M2I-CySat/Simulator-Interface-Board/cubesat Sim board.png

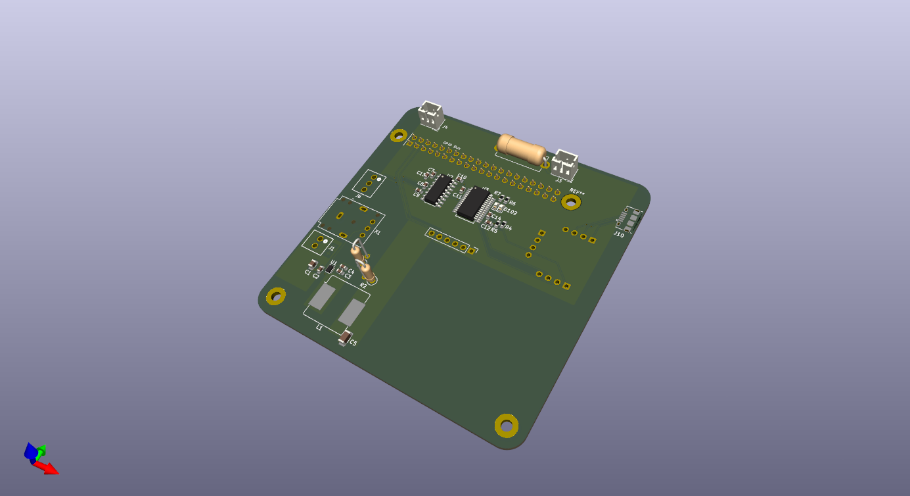
cubesat Sim board.png
