M2I-CySat/Simulator-Interface-Board/README.md

These are the KiCad project files for the Fall 2025 CySat Simulator interface board for HASP.

The files to submit to JLCPCB are in jlcpcb/production_files; the DigiKey BOM is in the main directory.
