M2I-CySat/Simulator-Interface-Board/DigiKey BOM.xlsx

Country of Origin may be different at time of shipment.
The HTSUS and ECCN information shown is for informational purposes only and is not a representation or warranty as to the accuracy or reliability of these classifications. All information is provided "as is" and is subject to change without notice. Any use made of the information provided is without recourse to Digi-Key and at the user's risk.
Index | Manufacturer Part Number | Manufacturer Name | Description | Lead Time | Availability | Stock Status | Assemblies | Attrition % | Requested Quantity 1 | Pack Quantity 1 | Pack Type 1 | Digi-Key Part Number 1 | Unit Price 1 | Extended Price 1 | Minimum Order Quantity 1 | Customer Reference | Requested Part Number | Lead Weeks | Datasheet | Reference Designator | US Import Tariff | Note | Part Status | RoHS Status | Moisture Sensitivity Level (MSL) | ECCN | HTSUS | Country of Origin | Environmental Information | Original Part numbers | Image | Product Notes
1 | OSTVN03A150 | On Shore Technology Inc. | TERM BLK 3P SIDE ENT 2.54MM PCB |  | 12,500 | In Stock | 2 |  | 1 | 2 | Bulk | ED10562-ND | 1.26000 | $2.52 | 1 |  | ED10562-ND | 8 | https://mm.digikey.com/Volume0/opasdata/d220001/medias/docus/1123/OSTVNXXA150.pdf |  | May apply on shipments to the U.S. |  | Active | ROHS3 Compliant | 1 (Unlimited) | EAR99 | 8536.90.4000 | China | https://www.on-shore.com/wp-content/uploads/RoHS3_REACH-STATEMENT-250.pdf | ED10562-ND | https://mm.digikey.com/Volume0/opasdata/d220001/medias/images/391/OSTVN03A150.jpg
2 | OSTVN02A150 | On Shore Technology Inc. | TERM BLK 2P SIDE ENT 2.54MM PCB |  | 17,626 | In Stock | 2 |  | 1 | 2 | Bulk | ED10561-ND | 0.87000 | $1.74 | 1 |  | ED10561-ND | 8 | https://mm.digikey.com/Volume0/opasdata/d220001/medias/docus/1123/OSTVNXXA150.pdf |  | May apply on shipments to the U.S. |  | Active | ROHS3 Compliant | 1 (Unlimited) | EAR99 | 8536.90.4000 | China | https://www.on-shore.com/wp-content/uploads/RoHS3_REACH-STATEMENT-250.pdf | ED10561-ND | https://mm.digikey.com/Volume0/opasdata/d220001/medias/images/410/OSTVN02A150.JPG
3 | 10118194-0001LF | Amphenol ICC (FCI) | CONN RCPT USB2.0 MICRO B SMD R/A |  | 127,424 | In Stock | 2 |  | 1 | 2 | Cut Tape (CT) | 609-4618-1-ND | 0.43000 | $0.86 | 1 |  | 609-4618-2-ND | 13 | https://cdn.amphenol-cs.com/media/wysiwyg/files/documentation/datasheet/inputoutput/io_usb_micro.pdf |  | May apply on shipments to the U.S. |  | Active | ROHS3 Compliant | 1 (Unlimited) | EAR99 | 8536.69.4040 | China |  | 609-4618-2-ND | https://mm.digikey.com/Volume0/opasdata/d220001/medias/images/525/10118194-0001LF.JPG
4 | 5999 | Adafruit Industries LLC | ADAFRUIT CH334F MINI 2-PORT USB |  | 29 | In Stock | 2 |  | 1 | 2 | Bulk | 1528-5999-ND | 4.50000 | $9.00 | 1 |  | 1528-5999-ND | 4 |  |  | N/A |  | Active | Unknown | 1 (Unlimited) | EAR99 | 8471.80.1000 | Hong Kong |  | 1528-5999-ND | https://mm.digikey.com/Volume0/opasdata/d220001/derivates/6/003/215/769/MFG_5999_web%28640x640%29.jpg
5 | SJ-3566AN | Same Sky (Formerly CUI Devices) | CONN JACK STEREO 3.5MM R/A |  | 597 | In Stock | 2 |  | 1 | 2 | Tray | CP-SJ-3566AN-ND | 1.79000 | $3.58 | 1 |  | CP-SJ-3566AN-ND | 8 | https://www.cuidevices.com/product/discontinued/sj-356xn.pdf |  | May apply on shipments to the U.S. |  | Active | ROHS3 Compliant | Not Applicable | EAR99 | 8536.69.4020 | China | https://www.cuidevices.com/product/resource/material-compliance/sj-3566an | CP-SJ-3566AN-ND | https://mm.digikey.com/Volume0/opasdata/d220001/medias/images/23/MFG_SJ-356XN.jpg
6 | RS02B12R00FE70 | Vishay Dale | RES 12 OHM 3W 1% WW AXIAL |  | 4,923 | In Stock | 2 |  | 1 | 2 | Cut Tape (CT) | RSB-12RCT-ND | 2.83000 | $5.66 | 1 |  | RSB-12RTR-ND | 12 | https://www.vishay.com/docs/30204/rsns.pdf |  | N/A |  | Active | ROHS3 Compliant | Not Applicable | EAR99 | 8533.21.0080 | Mexico |  | RSB-12RTR-ND | https://mm.digikey.com/Volume0/opasdata/d220001/derivates/6/010/196/904/RS01AR3300FE70_web%28640x640%29.jpg
