M2I-CySat/Simulator-Interface-Board/External_Libraries/symbols/SJ-3566AN.step

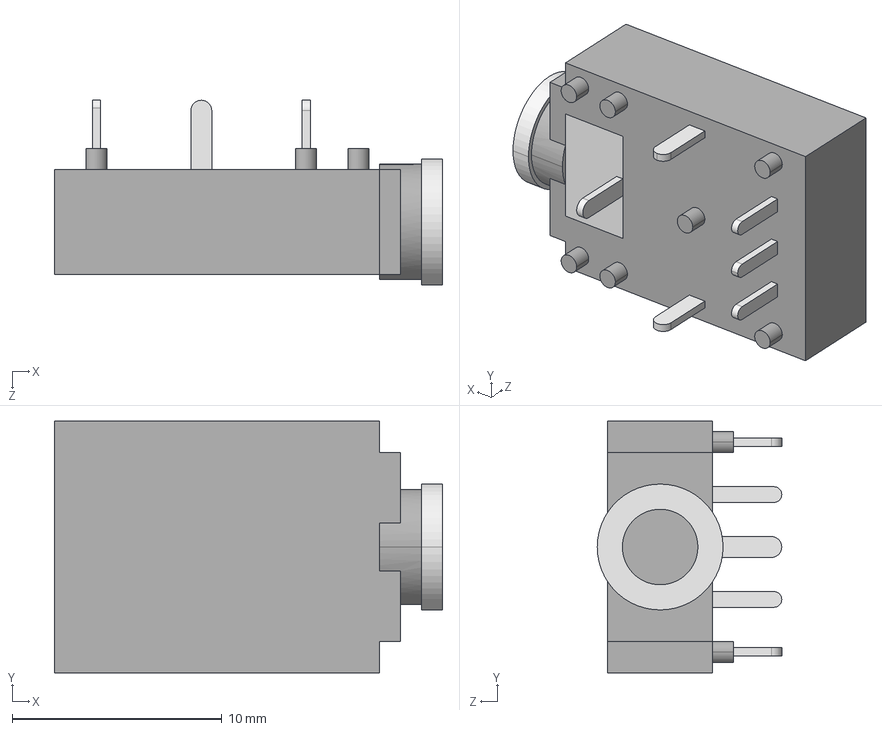
[picture p2: CAD file, 2025-11-07]
External_Libraries/symbols/SJ-3566AN.step
18.5 x 12.0 x 8.80 mm
