M2I-CySat/Simulator-Interface-Board/cubesat Sim board.kicad_pcb

## KiCad design cubesat Sim board.kicad_pcb (2025-11-10)

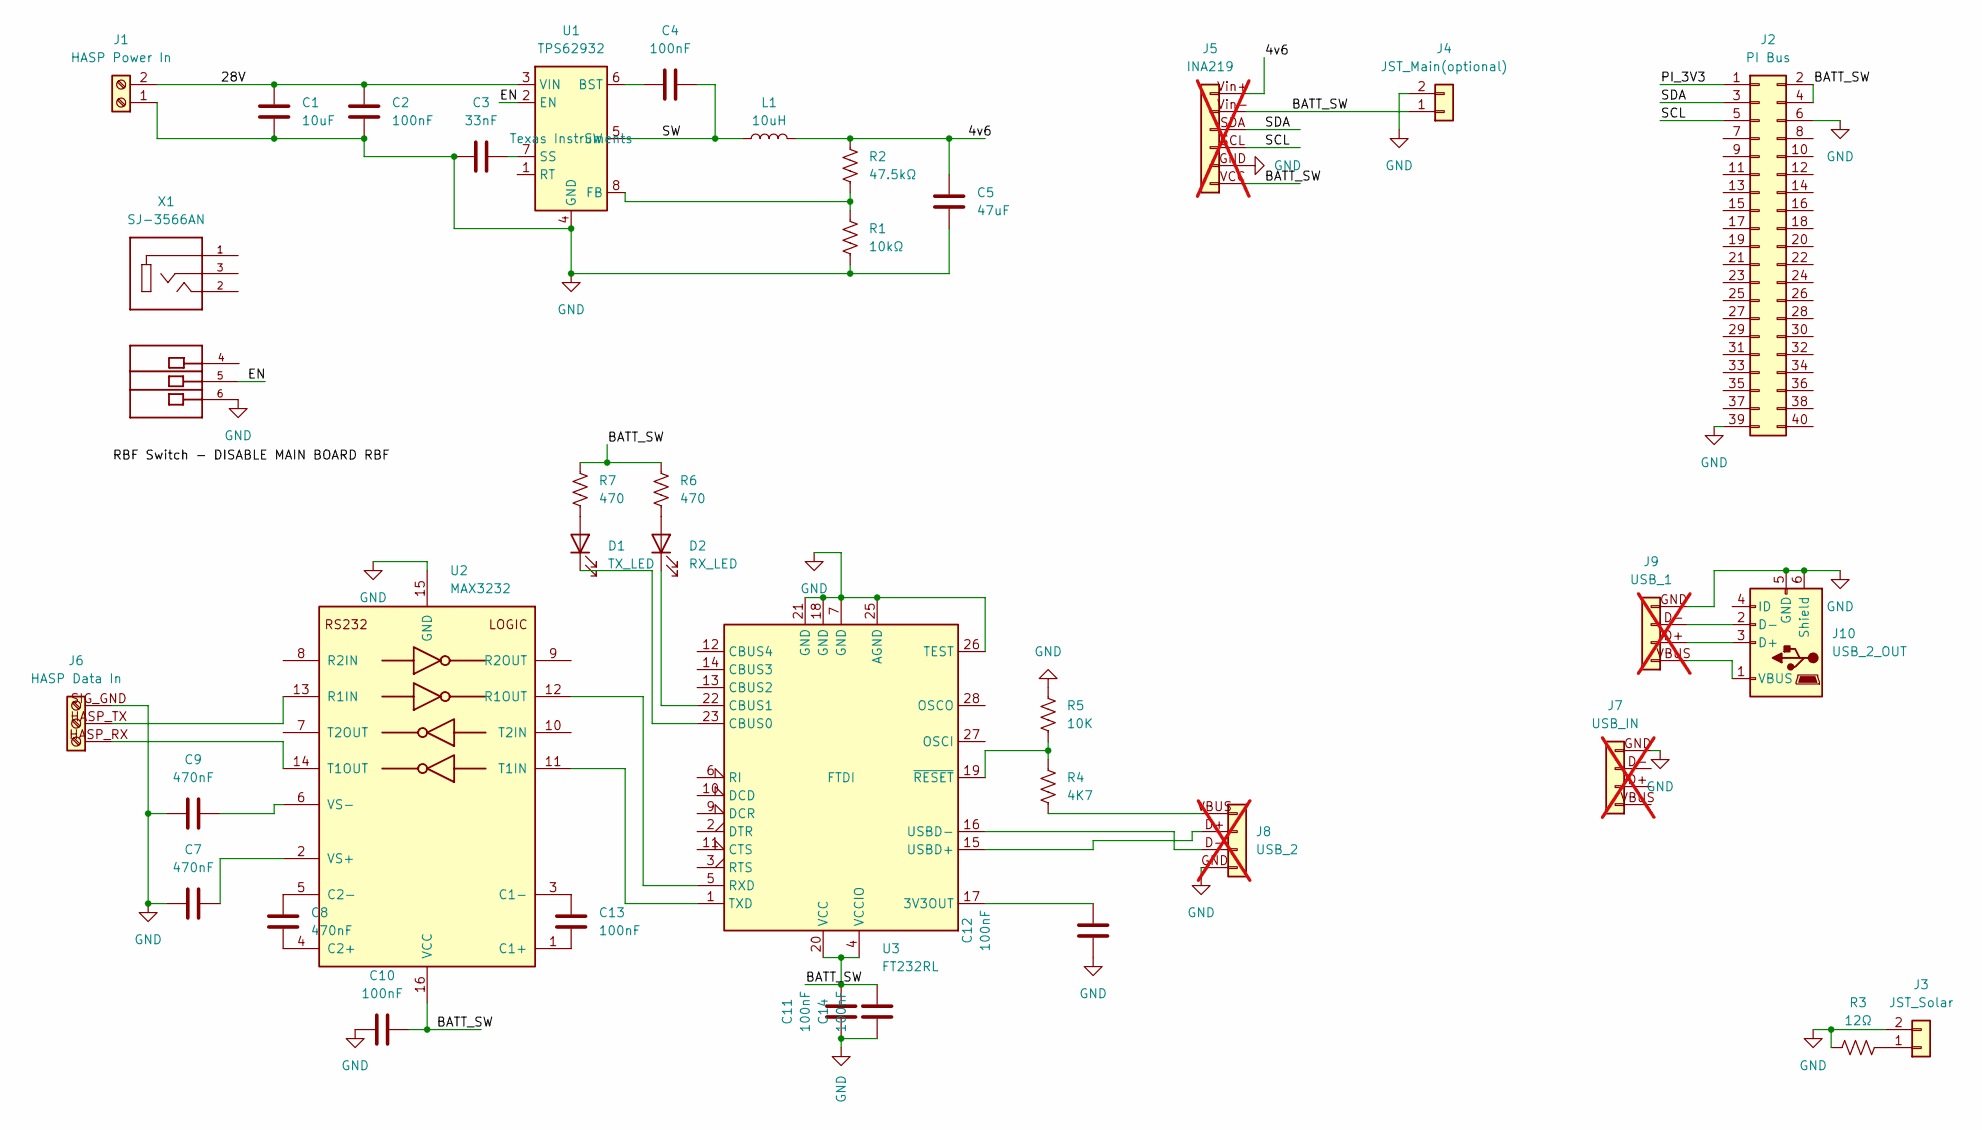
[picture p3: schematic cubesat Sim board.kicad_sch, CySat Simulator Power Board]

Parts:
C1: 10uF; C_0805_2012Metric
C2, C4, C10, C11, C12, C13, C14: 100nF; C_0603_1608Metric
C3: 33nF; C_0603_1608Metric
C5: 47uF; C_1206_3216Metric
C7, C8, C9: 470nF; C_0603_1608Metric
D1: TX_LED; LED_0603_1608Metric
D2: RX_LED; LED_0603_1608Metric
J1: HASP Power In; CONN_OSTVN02A150_OST
J2: PI Bus; PinSocket_2x20_P2.54mm_Vertical
J3: JST_Solar; JST_PH_B2B-PH-K_1x02_P2.00mm_Vertical
J4: JST_Main(optional); JST_PH_B2B-PH-K_1x02_P2.00mm_Vertical
J5: INA219; PinHeader_1x06_P2.54mm_Vertical; not fitted
J6: HASP Data In; CONN3_OSTVN03A150_OST
J7: USB_IN; PinHeader_1x04_P2.54mm_Vertical_USB; not fitted
J8: USB_2; PinHeader_1x04_P2.54mm_Vertical_USB; not fitted
J9: USB_1; PinHeader_1x04_P2.54mm_Vertical_USB; not fitted
J10: USB_2_OUT; USB_Micro-B_Amphenol_10118194-0001LF_Horizontal
L1: 10uH; L_Bourns_SRR1208_12.7x12.7mm
R1: 10kΩ; R_Axial_DIN0207_L6.3mm_D2.5mm_P2.54mm_Vertical
R2: 47.5kΩ; R_Axial_DIN0207_L6.3mm_D2.5mm_P2.54mm_Vertical
R3: 12Ω; R_Axial_DIN0614_L14.3mm_D5.7mm_P15.24mm_Horizontal
R4: 4K7; R_0603_1608Metric
R5: 10K; R_0603_1608Metric
R6, R7: 470; R_0603_1608Metric
U1: TPS62932; SOT-583-8
U2: MAX3232; SOIC-16_3.9x9.9mm_P1.27mm
U3: FT232RL; SSOP-28_5.3x10.2mm_P0.65mm
X1: SJ-3566AN; CUI_SJ-3566AN

Connections:
/4v6: C5.2, J5.Vin+ (Pin_6), L1.2, R2.1
/28V: C1.1, C2.1, J1.2, U1.3 (VIN)
/BATT_SW: C10.2, C11.2, C14.2, J2.2, J2.4, J4.1, J5.VCC (Pin_1), J5.Vin- (Pin_5), R6.1, R7.1, U2.16 (VCC), U3.4 (VCCIO), U3.20 (VCC)
/EN: U1.2 (EN), X1.5
/PI_3V3: J2.1
/SCL: J2.5, J5.SCL (Pin_3)
/SDA: J2.3, J5.SDA (Pin_4)
/SW: C4.2, L1.1, U1.5 (SW)
GND: C1.2, C2.2, C3.1, C5.1, C7.1, C9.2, C10.1, C11.1, C12.1, C14.1, J1.1, J2.6, J2.39, J3.2, J4.2, J5.GND (Pin_2), J6.SIG_GND (Pin_3), J7.GND (Pin_4), J8.GND (Pin_4), J9.GND (Pin_4), J10.5 (GND), J10.6 (Shield), R1.2, R3.1, R5.1, U1.4 (GND), U2.15 (GND), U3.7 (GND), U3.18 (GND), U3.21 (GND), U3.25 (AGND), U3.26 (TEST), X1.6
unnamed: D1.2 (A), R7.2
unnamed: D1.1 (K), U3.23 (CBUS0)
unnamed: D2.2 (A), R6.2
unnamed: D2.1 (K), U3.22 (CBUS1)
unnamed: J3.1, R3.2
unnamed: J6.HASP_RX (Pin_1), U2.14 (T1OUT)
unnamed: J6.HASP_TX (Pin_2), U2.13 (R1IN)
unnamed: J8.VBUS (Pin_1), R4.2
unnamed: J8.D+ (Pin_2), U3.15 (USBD+)
unnamed: J8.D- (Pin_3), U3.16 (USBD-)
unnamed: J9.D+ (Pin_2), J10.3 (D+)
unnamed: J9.D- (Pin_3), J10.2 (D-)
unnamed: J9.VBUS (Pin_1), J10.1 (VBUS)
unnamed: C4.1, U1.6 (BST)
unnamed: R1.1, R2.2, U1.8 (FB)
unnamed: C3.2, U1.7 (SS)
unnamed: C13.1, U2.1 (C1+)
unnamed: C13.2, U2.3 (C1-)
unnamed: C8.1, U2.4 (C2+)
unnamed: C8.2, U2.5 (C2-)
unnamed: U2.12 (R1OUT), U3.5 (RXD)
unnamed: U2.11 (T1IN), U3.1 (TXD)
unnamed: C7.2, U2.2 (VS+)
unnamed: C9.1, U2.6 (VS-)
unnamed: C12.2, U3.17 (3V3OUT)
unnamed: R4.1, R5.2, U3.19 (~RESET)

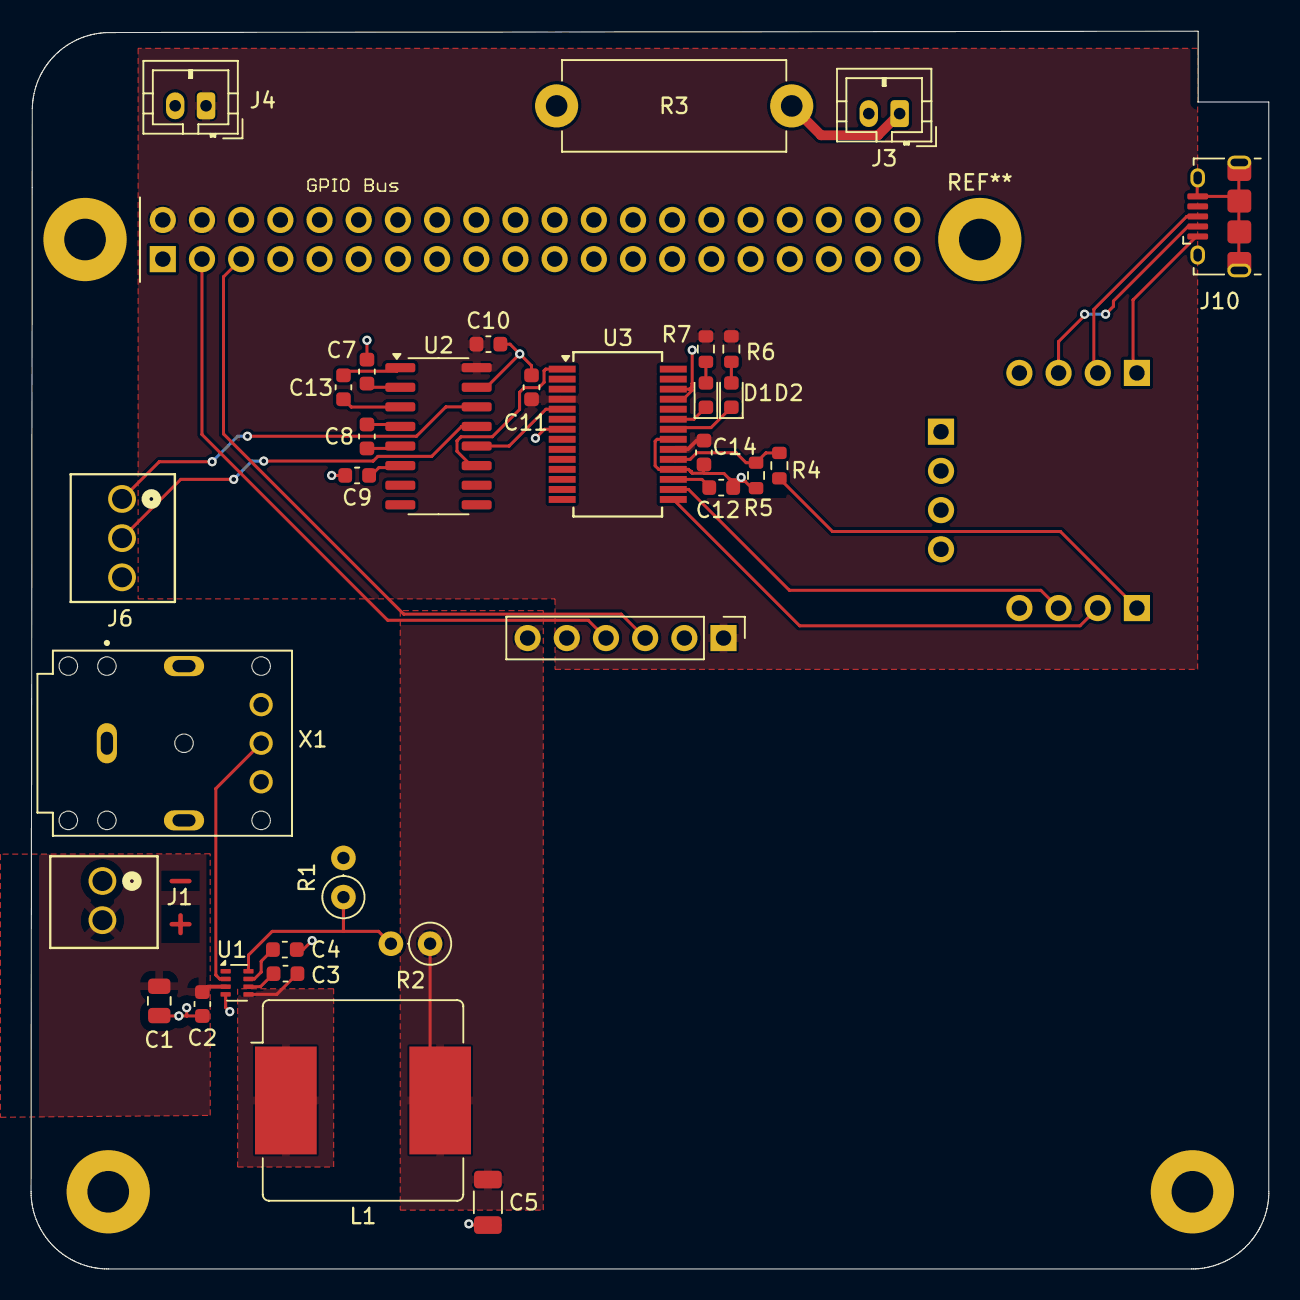
[picture p4: board cubesat Sim board.kicad_pcb from above]

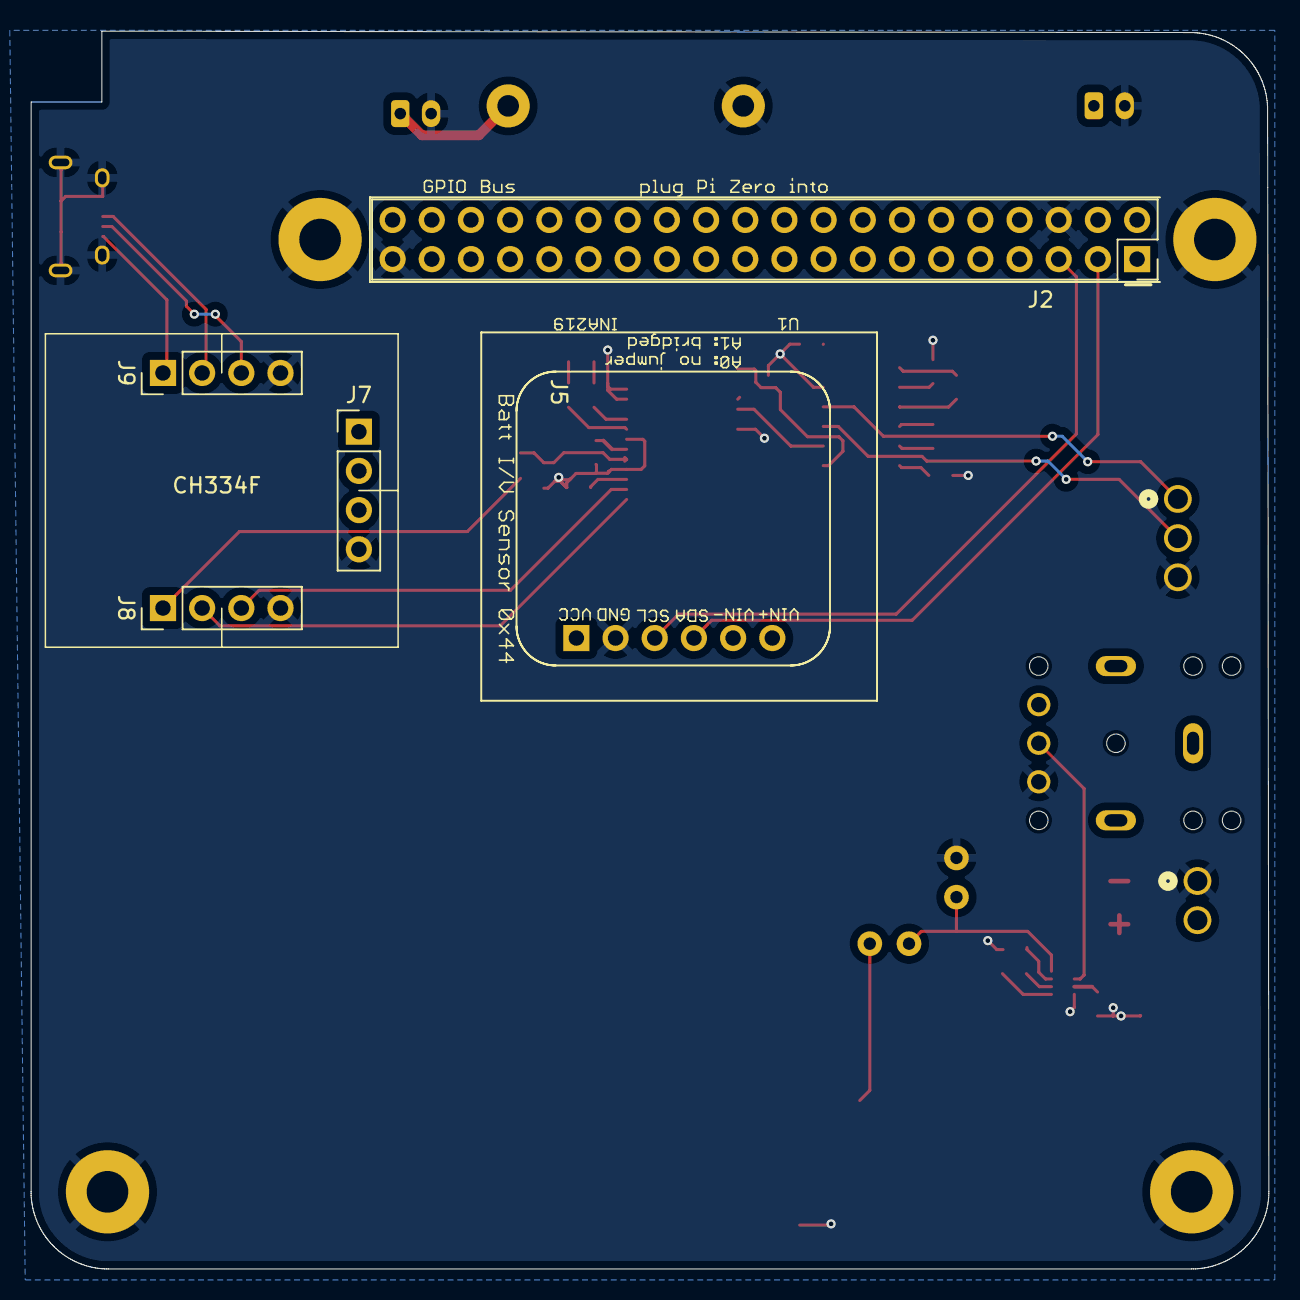
[picture p5: board cubesat Sim board.kicad_pcb from below]

Board: 2 copper layers, 80.2 x 80.2 mm, 37 parts (4 on the bottom side), 34 nets.
