M2I-CySat/Simulator-Interface-Board/(commit log)

2025-11-07 Add files via upload
    Initial Commit
    [BOM-cubesat Sim board.csv, SJ-3566AN.step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]
2025-11-07 BOM
    Updated BOMs
    [BOM-cubesat Sim board.csv, DigiKey BOM.xlsx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]
2025-11-10 Added cutout for mounting
    Added cutout for mounting as requested by structures team
    [cubesat Sim board-CuBottom.gbr, cubesat Sim board-CuTop.gbr, cubesat Sim board-EdgeCuts.gbr, cubesat Sim board-MaskBottom.gbr, cubesat Sim board-MaskTop.gbr, cubesat Sim board-NPTH.drl, cubesat Sim board-PTH.drl, cubesat Sim board-SilkBottom.gbr]
2026-02-19 Added datasheet for regulator
